AnalogLamb/Maple-Eye-ESP32S3-Alef/Schematic/SCH__Maple_Eye_ESP32S3_Alef.pdf

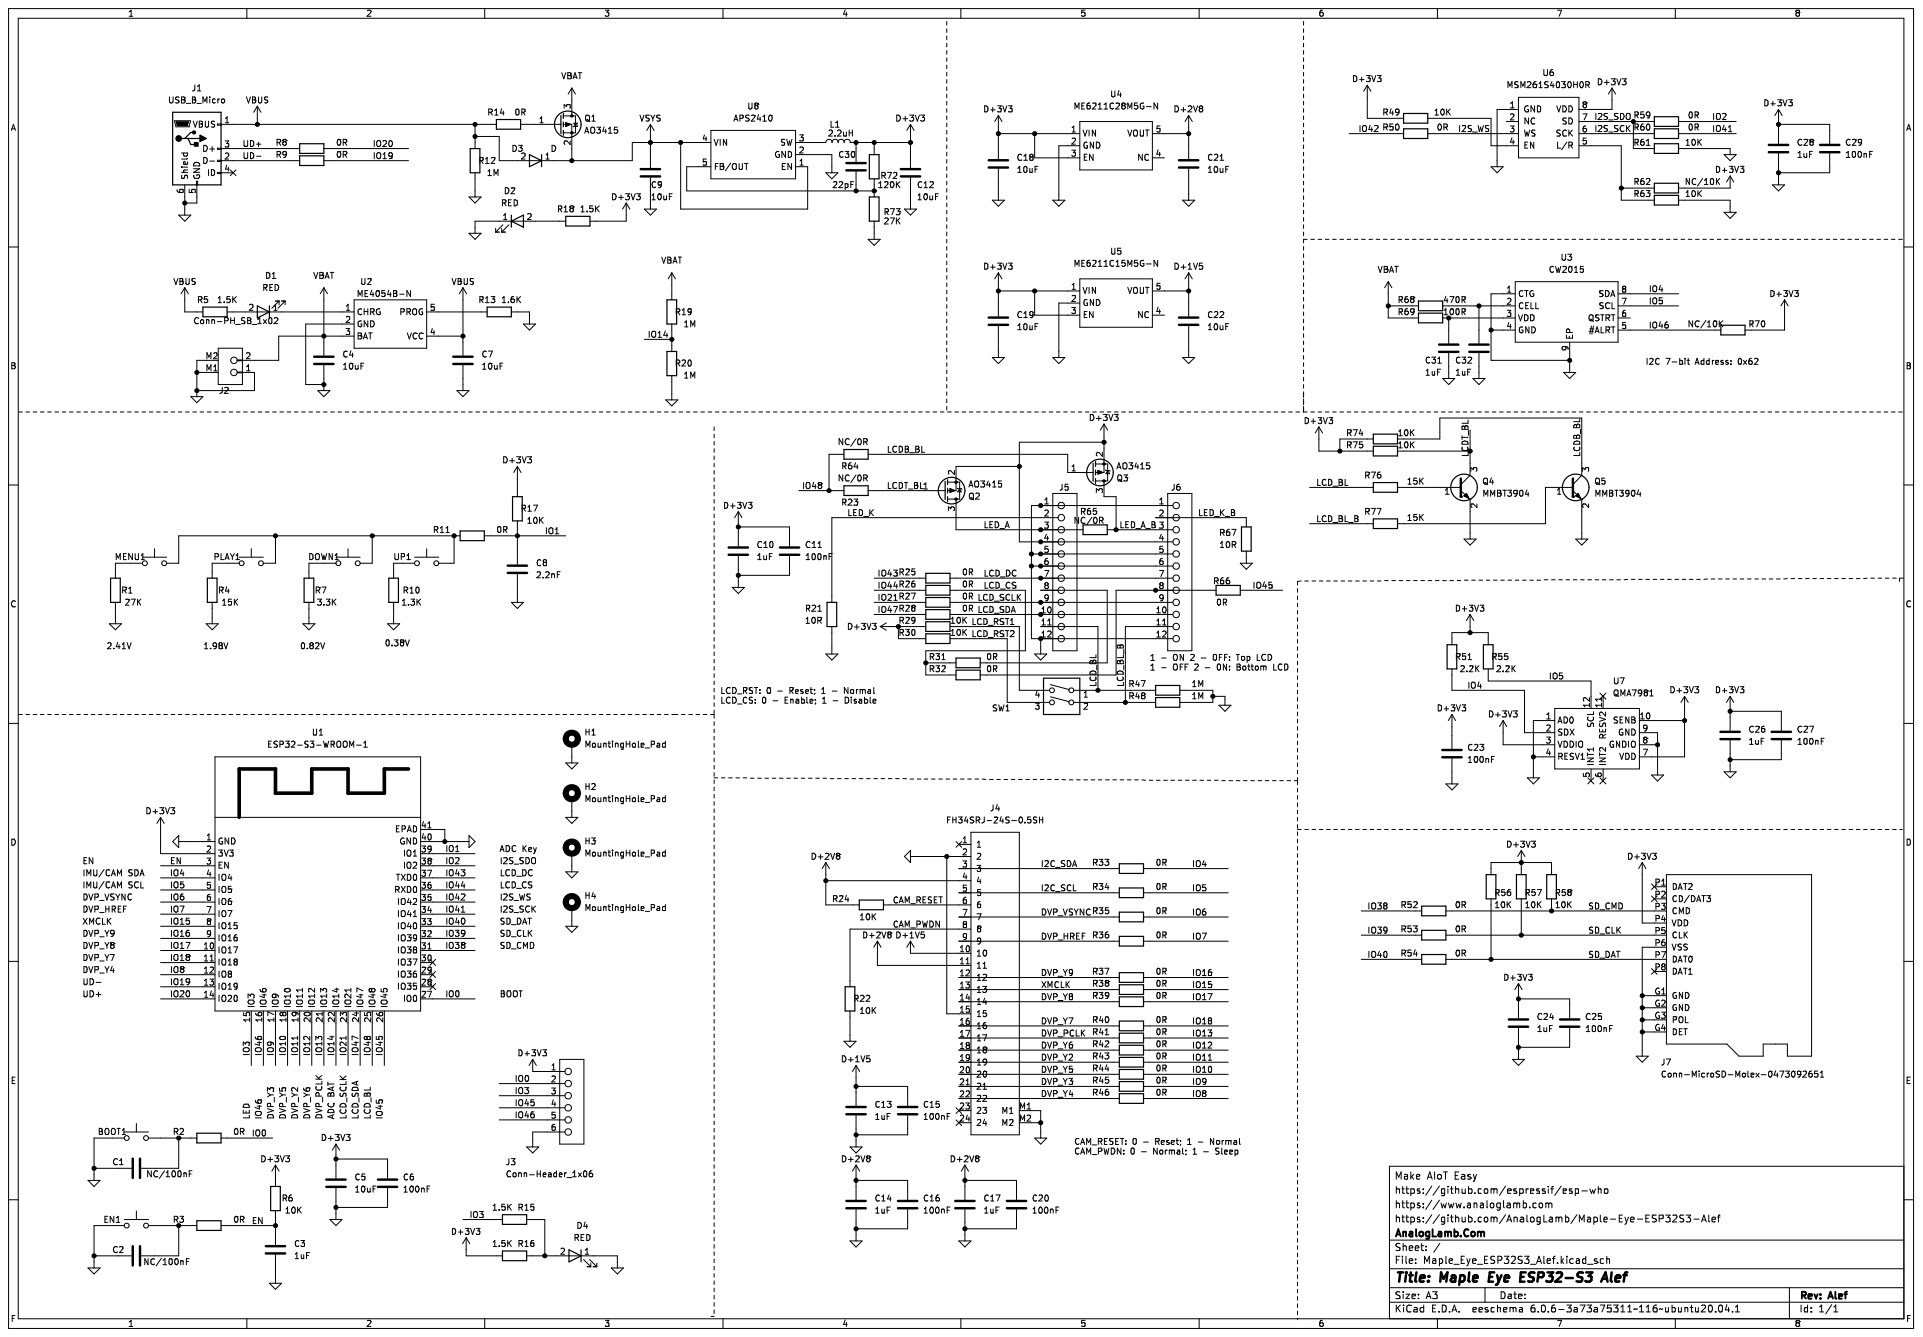
[picture p1: page 1]
