AnalogLamb/Maple-Eye-ESP32S3-Alef/Kicad_Project/Maple_Eye_ESP32S3_Alef.kicad_pcb

## KiCad design Kicad_Project/Maple_Eye_ESP32S3_Alef.kicad_pcb (2022-10-10)

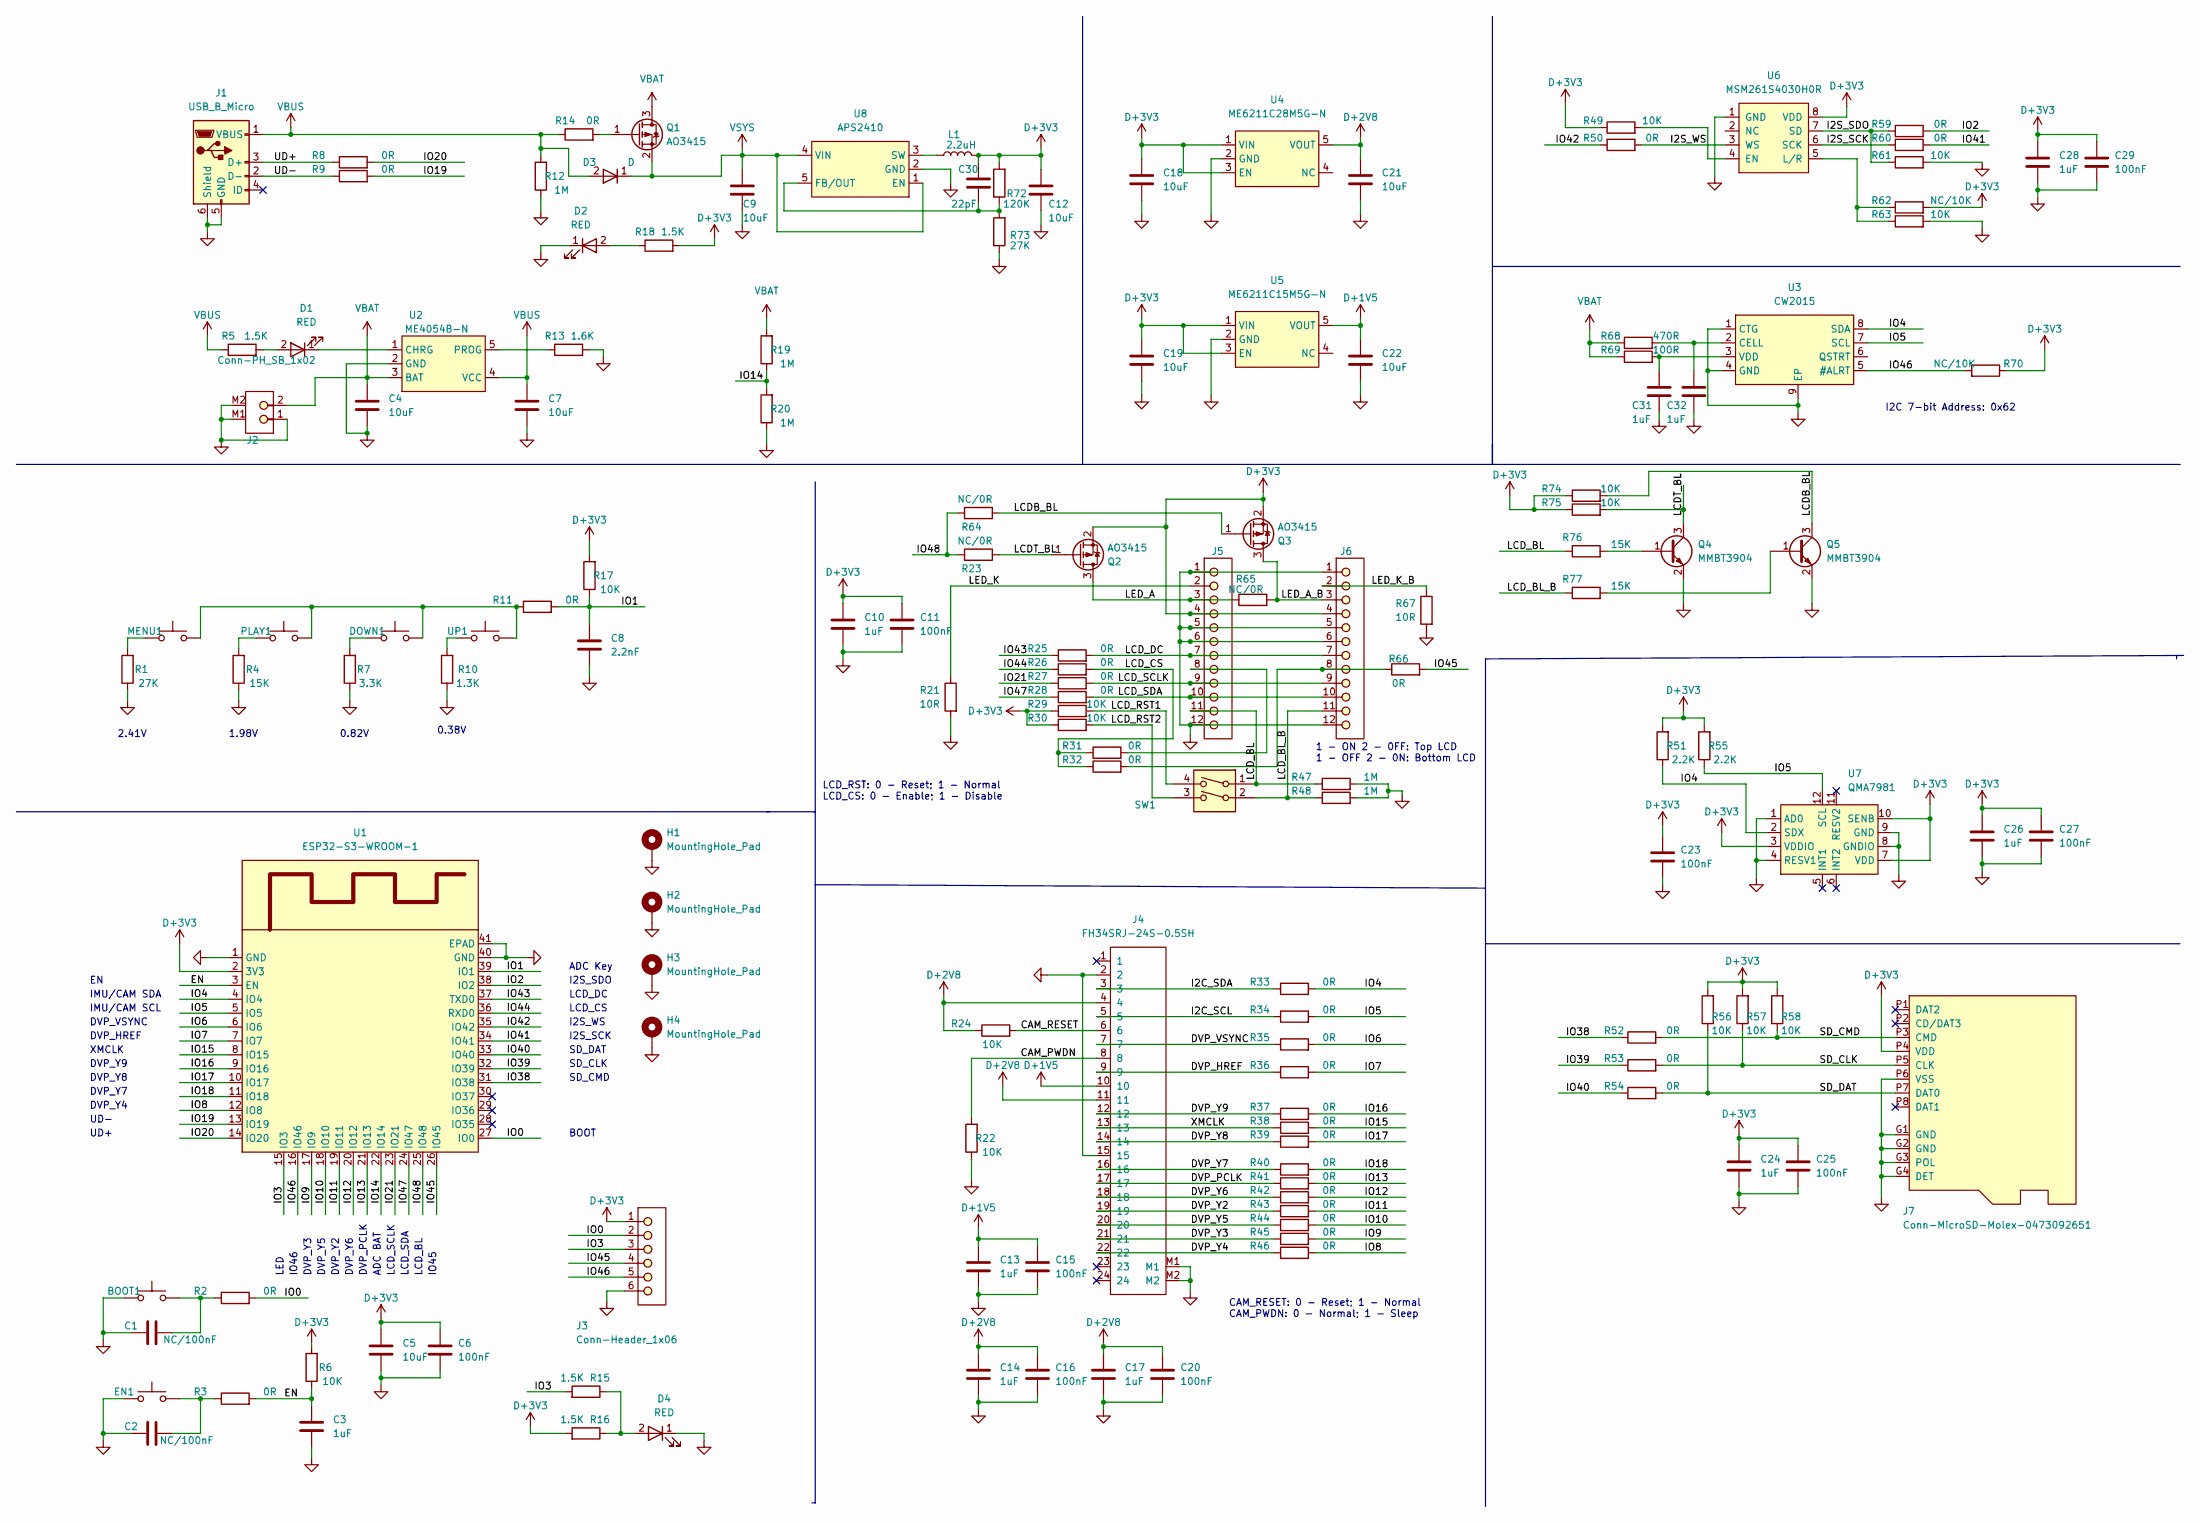
[picture p2: schematic Maple_Eye_ESP32S3_Alef.kicad_sch, Maple Eye ESP32-S3 Alef]

Parts:
BOOT1: SW_Push; PB_3x4MM_2P
C1, C2: NC/100nF; 0402C
C3, C10, C13, C14, C17, C24, C26, C28, C31, C32: 1uF; 0402C
C4, C5, C7, C9, C12, C18, C19, C21, C22: 10uF; 0402C
C6, C11, C15, C16, C20, C23, C25, C27, C29: 100nF; 0402C
C8: 2.2nF; 0402C
C30: 22pF; 0402C
D1, D2, D4: RED; 0402D
D3: D; SOD-123
DOWN1: SW_Push; PB_3X4MM_2P_HS
EN1: SW_Push; PB_3x4MM_2P
H1, H2, H3, H4: MountingHole_Pad; MountingHole_2.2mm_M2_Pad_Via
J1: USB_B_Micro; MICRO-USB5+4P-SMD-0.65-B
J2: Conn-PH_SB_1x02; S2B-PH
J3: Conn-Header_1x06; 1X06
J4: FH34SRJ-24S-0.5SH; Conn-FPC-HRS-FH34SRJ-24S-0.5SH
J5, J6: Conn-Header_1x12; LCD_1.3_SPI
J7: Conn-MicroSD-Molex-0473092651
L1: 2.2uH; L_1008_2520Metric
MENU1: SW_Push; PB_3X4MM_2P_HS
PLAY1: SW_Push; PB_3X4MM_2P_HS
Q1, Q2, Q3: AO3415; SOT23-3
Q4, Q5: MMBT3904; SOT23-3
R1, R73: 27K; 0402R
R2, R3, R8, R9, R11, R14, R25, R26, R27, R28, R31, R32, R33, R34, R35, R36, R37, R38, R39, R40, R41, R42, R43, R44, R45, R46, R50, R52, R53, R54, R59, R60, R66: 0R; 0402R
R4, R76, R77: 15K; 0402R
R5, R15, R16, R18: 1.5K; 0402R
R6, R17, R22, R24, R29, R30, R49, R56, R57, R58, R61, R63, R74, R75: 10K; 0402R
R7: 3.3K; 0402R
R10: 1.3K; 0402R
R12, R19, R20, R47, R48: 1M; 0402R
R13: 1.6K; 0402R
R21, R67: 10R; 0603
R23, R64, R65: NC/0R; 0402R
R51, R55: 2.2K; 0402R
R62, R70: NC/10K; 0402R
R68: 470R; 0402R
R69: 100R; 0402R
R72: 120K; 0402R
SW1: SW_DIP_x02; CHS-02B
U1: ESP32-S3-WROOM-1
U2: ME4054B-N; SOT23-5
U3: CW2015; TDFN-8-1EP_3x2mm_P0.5mm_EP1.4x1.4mm
U4: ME6211C28M5G-N; SOT23-5
U5: ME6211C15M5G-N; SOT23-5
U6: MSM261S4030H0R
U7: QMA7981; LGA-12_2x2mm_P0.5mm
U8: APS2410; SOT23-5
UP1: SW_Push; PB_3X4MM_2P_HS

Connections:
+1V5: C13.1, C15.1, C22.1, J4.10, U5.5 (VOUT)
+2V8: C14.1, C16.1, C17.1, C20.1, C21.1, J4.4, J4.11, R24.1, U4.5 (VOUT)
+3V3: C5.1, C6.1, C10.1, C11.1, C12.1, C18.1, C19.1, C23.1, C24.1, C25.1, C26.1, C27.1, C28.1, C29.1, C30.1, J3.1, J5.4, J6.4, J7.P4 (VDD), L1.2, Q2.2 (S), Q3.2 (S), R6.2, R16.2, R17.2, R18.2, R29.1, R30.1, R49.1, R51.2, R55.2, R56.2, R57.2, R58.2, R62.2, R70.1, R72.2, R74.1, R75.1, U1.2 (3V3), U4.1 (VIN), U4.3 (EN), U5.1 (VIN), U5.3 (EN), U6.8 (VDD), U7.3 (VDDIO), U7.7 (VDD), U7.10 (SENB)
/CAM_PWDN: J4.8, R22.2
/CAM_RESET: J4.6, R24.2
/DVP_HREF: J4.9, R36.1
/DVP_PCLK: J4.17, R41.1
/DVP_VSYNC: J4.7, R35.1
/DVP_Y2: J4.19, R43.1
/DVP_Y3: J4.21, R45.1
/DVP_Y4: J4.22, R46.1
/DVP_Y5: J4.20, R44.1
/DVP_Y6: J4.18, R42.1
/DVP_Y7: J4.16, R40.1
/DVP_Y8: J4.14, R39.1
/DVP_Y9: J4.12, R37.1
/EN: C3.1, R3.2, R6.1, U1.3 (EN)
/I2C_SCL: J4.5, R34.1
/I2C_SDA: J4.3, R33.1
/I2S_SCK: R60.1, U6.6 (SCK)
/I2S_SDO: R59.1, R61.1, U6.7 (SD)
/I2S_WS: R50.2, U6.3 (WS)
/IO0: J3.2, R2.2, U1.27 (IO0)
/IO1: C8.1, R11.2, R17.1, U1.39 (IO1)
/IO2: R59.2, U1.38 (IO2)
/IO3: J3.3, R15.2, U1.15 (IO3)
/IO4: R33.2, R51.1, U1.4 (IO4), U3.8 (SDA), U7.2 (SDX)
/IO5: R34.2, R55.1, U1.5 (IO5), U3.7 (SCL), U7.12 (SCL)
/IO6: R35.2, U1.6 (IO6)
/IO7: R36.2, U1.7 (IO7)
/IO8: R46.2, U1.12 (IO8)
/IO9: R45.2, U1.17 (IO9)
/IO10: R44.2, U1.18 (IO10)
/IO11: R43.2, U1.19 (IO11)
/IO12: R42.2, U1.20 (IO12)
/IO13: R41.2, U1.21 (IO13)
/IO14: R19.1, R20.2, U1.22 (IO14)
/IO15: R38.2, U1.8 (IO15)
/IO16: R37.2, U1.9 (IO16)
/IO17: R39.2, U1.10 (IO17)
/IO18: R40.2, U1.11 (IO18)
/IO19: R9.2, U1.13 (IO19)
/IO20: R8.2, U1.14 (IO20)
/IO21: R27.1, U1.23 (IO21)
/IO38: R52.1, U1.31 (IO38)
/IO39: R53.1, U1.32 (IO39)
/IO40: R54.1, U1.33 (IO40)
/IO41: R60.2, U1.34 (IO41)
/IO42: R50.1, U1.35 (IO42)
/IO43: R25.1, U1.37 (TXD0)
/IO44: R26.1, U1.36 (RXD0)
/IO45: J3.4, R66.2, U1.26 (IO45)
/IO46: J3.5, R70.2, U1.16 (IO46), U3.5 (#ALRT)
/IO47: R28.1, U1.24 (IO47)
/IO48: R23.2, R64.2, U1.25 (IO48)
/LCDB_BL: Q3.1 (G), Q5.3 (C), R64.1, R74.2
/LCDT_BL: Q2.1 (G), Q4.3 (C), R23.1, R75.2
/LCD_BL: J5.11, R47.1, R76.1, SW1.1
/LCD_BL_B: J6.11, R48.1, R77.1, SW1.2
/LCD_CS: R26.2, R31.1, R32.1
/LCD_DC: J5.7, J6.7, R25.2
/LCD_RST1: R29.2, SW1.4
/LCD_RST2: R30.2, SW1.3
/LCD_SCLK: J5.9, J6.9, R27.2
/LCD_SDA: J5.10, J6.10, R28.2
/LED_A: J5.3, Q2.3 (D), R65.1
/LED_A_B: J6.3, Q3.3 (D), R65.2
/LED_K: J5.2, R21.1
/LED_K_B: J6.2, R67.1
/SD_CLK: J7.P5 (CLK), R53.2, R57.1
/SD_CMD: J7.P3 (CMD), R52.2, R58.1
/SD_DAT: J7.P7 (DAT0), R54.2, R56.1
/UD+: J1.3 (D+), R8.1
/UD-: J1.2 (D-), R9.1
/XMCLK: J4.13, R38.1
GND: BOOT1.1, C1.1, C2.1, C3.2, C4.2, C5.2, C6.2, C7.2, C8.2, C9.2, C10.2, C11.2, C12.2, C13.2, C14.2, C15.2, C16.2, C17.2, C18.2, C19.2, C20.2, C21.2, C22.2, C23.2, C24.2, C25.2, C26.2, C27.2, C28.2, C29.2, C31.2, C32.2, D2.1 (K), D4.1 (K), EN1.1, H1.1, H2.1, H3.1, H4.1, J1.5 (GND), J1.6 (Shield), J2.1, J2.M1, J2.M2, J3.6, J4.2, J4.15, J4.M1, J4.M2, J5.1, J5.5, J5.6, J5.12, J6.1, J6.5, J6.6, J6.12, J7.G1 (GND), J7.G2 (GND), J7.G3 (POL), J7.G4 (DET), J7.P6 (VSS), Q4.2 (E), Q5.2 (E), R1.1, R4.1, R7.1, R10.1, R12.1, R13.2, R20.1, R21.2, R22.1, R47.2, R48.2, R61.2, R63.2, R67.2, R73.1, U1.1 (GND), U1.40 (GND), U1.41 (EPAD), U2.2 (GND), U3.1 (CTG), U3.4 (GND), U3.9 (EP), U4.2 (GND), U5.2 (GND), U6.1 (GND), U7.1 (AD0), U7.4 (RESV1), U7.8 (GNDIO), U7.9 (GND), U8.2 (GND)
unnamed: BOOT1.2, C1.2, R2.1
unnamed: C2.2, EN1.2, R3.1
unnamed: C30.2, R72.1, R73.2, U8.5 (FB/OUT)
unnamed: C31.1, R69.2, U3.3 (VDD)
unnamed: C32.1, R68.2, U3.2 (CELL)
unnamed: D1.1 (K), U2.1 (CHRG)
unnamed: D1.2 (A), R5.2
unnamed: D2.2 (A), R18.1
unnamed: D4.2 (A), R15.1, R16.1
unnamed: DOWN1.1, R7.2
unnamed: DOWN1.2, MENU1.2, PLAY1.2, R11.1, UP1.2
unnamed: J5.8, R31.2
unnamed: J6.8, R32.2, R66.1
unnamed: L1.1, U8.3 (SW)
unnamed: MENU1.1, R1.2
unnamed: PLAY1.1, R4.2
unnamed: Q1.1 (G), R14.2
unnamed: Q4.1 (B), R76.2
unnamed: Q5.1 (B), R77.2
unnamed: R10.2, UP1.1
unnamed: R13.1, U2.5 (PROG)
unnamed: R49.2, U6.4 (EN)
unnamed: R62.1, R63.1, U6.5 (L/R)
VBAT: C4.1, J2.2, Q1.3 (D), R19.2, R68.1, R69.1, U2.3 (BAT)
VBUS: C7.1, D3.2 (A), J1.1 (VBUS), R5.1, R12.2, R14.1, U2.4 (VCC)
VSYS: C9.1, D3.1 (K), Q1.2 (S), U8.1 (EN), U8.4 (VIN)

Notes on the sheet:
DVP_VSYNC
SD_CMD
DVP_Y9
DVP_Y7
DVP_Y4
LCD_DC
0.38V
UD+
1 - ON 2 - 0FF: Top LCD 1 - OFF 2 - 0N: Bottom LCD
BOOT
DVP_HREF
DVP_Y6
DVP_Y8
1.98V
LCD_BL
LCD_SCLK
2.41V
IMU/CAM SCL
CAM_RESET: 0 - Reset; 1 - Normal CAM_PWDN: 0 - Normal; 1 - Sleep
DVP_Y3
DVP_Y2
UD-
DVP_Y5
IO45
I2C 7-bit Address: 0x62
0.82V
SD_CLK
I2S_WS
XMCLK
ADC Key
LED
LCD_RST: 0 - Reset; 1 - Normal LCD_CS: 0 - Enable; 1 - Disable
I2S_SCK
DVP_PCLK
LCD_CS
LCD_SDA
ADC BAT
IMU/CAM SDA
I2S_SDO
IO46
SD_DAT

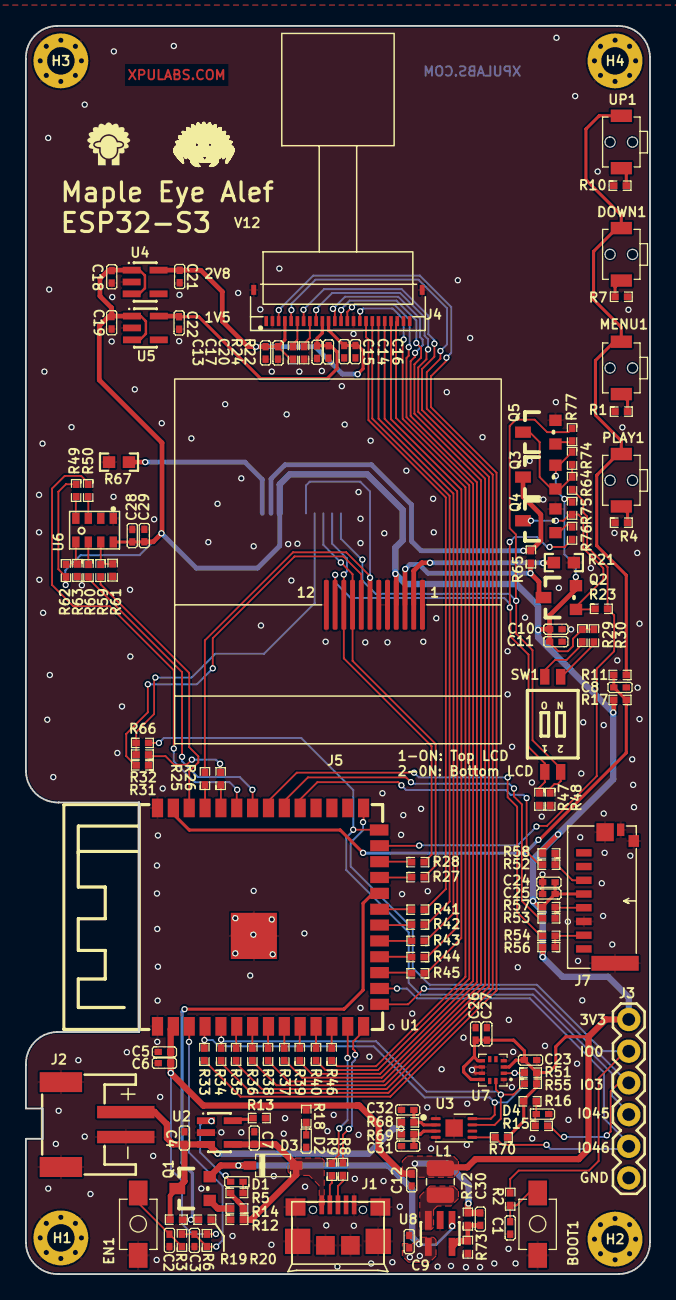
[picture p3: board Maple_Eye_ESP32S3_Alef.kicad_pcb from above]

Board: 2 copper layers, 50.0 x 100.0 mm, 144 parts (1 on the bottom side), 102 nets.
